Matteoleme/LaserGate/docs/FinalDelivery/test_accuracy/terminal_tof.md

Sensor 1 Triggered
Entry detected. People counter: 1
Reset to IDLE - Area Clear
No activity - deep sleep activate ...
ESP-ROM:esp32s3-20210327
Build:Mar 27 2021
rst:0x5 (DSLEEP),boot:0x9 (SPI_FAST_FLASH_BOOT)
pro cpu reset by JTAG
SPIWP:0xee
mode:DIO, clock div:1
load:0x3fce2820,len:0x116c
load:0x403c8700,len:0xc2c
load:0x403cb700,len:0x3108
entry 0x403c88b8
Wake up due PIR detection
Sensor Configuration ...
Sensors successfully configured.
Setup completed
Sensor 1 Triggered
Entry detected. People counter: 2
Reset to IDLE - Area Clear
No activity - deep sleep activate ...
ESP-ROM:esp32s3-20210327
Build:Mar 27 2021
rst:0x5 (DSLEEP),boot:0x9 (SPI_FAST_FLASH_BOOT)
pro cpu reset by JTAG
SPIWP:0xee
mode:DIO, clock div:1
load:0x3fce2820,len:0x116c
load:0x403c8700,len:0xc2c
load:0x403cb700,len:0x3108
entry 0x403c88b8
Wake up due PIR detection
Sensor Configuration ...
Sensors successfully configured.
Setup completed
Both Sensors Triggered!
Entry detected. People counter: 3
Reset to IDLE - Area Clear
Sensor 1 Triggered
Entry detected. People counter: 4
Reset to IDLE - Area Clear
No activity - deep sleep activate ...
ESP-ROM:esp32s3-20210327
Build:Mar 27 2021
rst:0x5 (DSLEEP),boot:0x9 (SPI_FAST_FLASH_BOOT)
pro cpu reset by JTAG
SPIWP:0xee
mode:DIO, clock div:1
load:0x3fce2820,len:0x116c
load:0x403c8700,len:0xc2c
load:0x403cb700,len:0x3108
entry 0x403c88b8
Wake up due PIR detection
Sensor Configuration ...
Sensors successfully configured.
Setup completed
Both Sensors Triggered!
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
Sensor 2 Triggered
Exit detected. People counter: 15
Reset to IDLE - Area Clear
Sensor 1 Triggered
Entry detected. People counter: 16
Reset to IDLE - Area Clear
Sensor 1 Triggered
Entry detected. People counter: 17
Reset to IDLE - Area Clear
No activity - deep sleep activate ...
