Matteoleme/LaserGate/docs/FinalDelivery/test_accuracy/terminal_ultrasonic.md

o activity - deep sleep activate
ESP-ROM:esp32s3-20210327
Build:Mar 27 2021
rst:0x5 (DSLEEP),boot:0x8 (SPI_FAST_FLASH_BOOT)
pro cpu reset by JTAG
SPIWP:0xee
mode:DIO, clock div:1
load:0x3fce2820,len:0x116c
load:0x403c8700,len:0xc2c
load:0x403cb700,len:0x3108
entry 0x403c88b8
Wake up due PIR detection
Setup completed
Sensor 2 Triggered!
No activity - deep sleep activate
ESP-ROM:esp32s3-20210327
Build:Mar 27 2021
rst:0x5 (DSLEEP),boot:0x8 (SPI_FAST_FLASH_BOOT)
SPIWP:0xee
mode:DIO, clock div:1
load:0x3fce2820,len:0x116c
load:0x403c8700,len:0xc2c
load:0x403cb700,len:0x3108
entry 0x403c88b8
Wake up due PIR detection
Setup completed
Sensor 2 Triggered!
Exit detected. People counter: 0
No activity - deep sleep activate
ESP-ROM:esp32s3-20210327
Build:Mar 27 2021
rst:0x5 (DSLEEP),boot:0x8 (SPI_FAST_FLASH_BOOT)
pro cpu reset by JTAG
SPIWP:0xee
mode:DIO, clock div:1
load:0x3fce2820,len:0x116c
load:0x403c8700,len:0xc2c
load:0x403cb700,len:0x3108
entry 0x403c88b8
Wake up due PIR detection
Setup completed
Sensor 2 Triggered!
Exit detected. People counter: 0
Sensor 2 Triggered!
Exit detected. People counter: 0
Sensor 1 Triggered!
Entry detected. People counter: 1
Both Sensors Triggered!
Entry detected. People counter: 2
Both Sensors Triggered!
Entry detected. People counter: 3
Sensor 1 Triggered!
Entry detected. People counter: 4
Both Sensors Triggered!
Strange detection, reset state...
Both Sensors Triggered!
Entry detected. People counter: 5
WiFi connection.... connected!
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
Build:Mar 27 2021
rst:0x5 (DSLEEP),boot:0x8 (SPI_FAST_FLASH_BOOT)
pro cpu reset by JTAG
SPIWP:0xee
mode:DIO, clock div:1
load:0x3fce2820,len:0x116c
load:0x403c8700,len:0xc2c
load:0x403cb700,len:0x3108
entry 0x403c88b8
Wake up due PIR detection
Setup completed
Sensor 2 Triggered!
